P-Hoep/filter-design/bottle_filter_tank_hook.stl

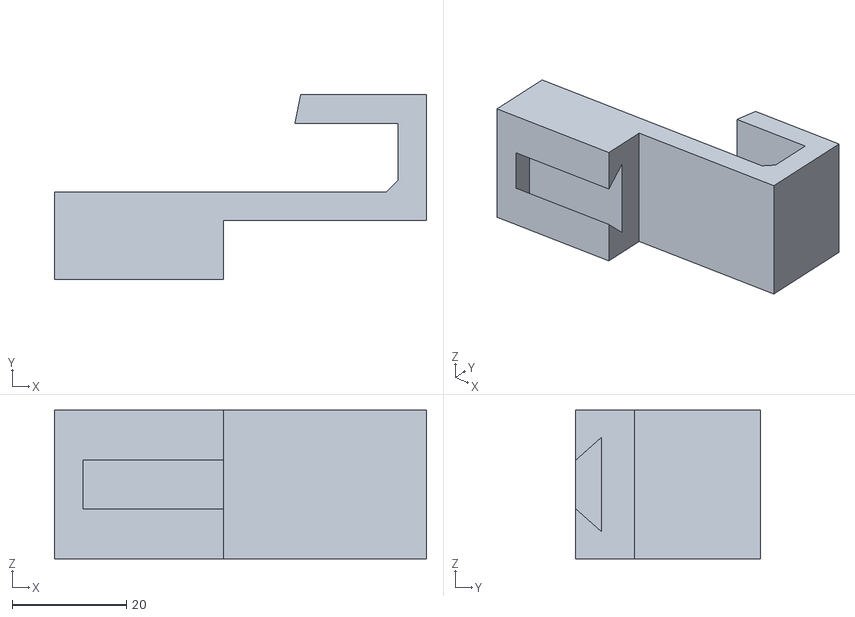
[picture p7: CAD file, 2026-10-12]
bottle_filter_tank_hook.stl
65.0 x 32.2 x 26.0
