P-Hoep/filter-design/mockup/installation_layout.dxf

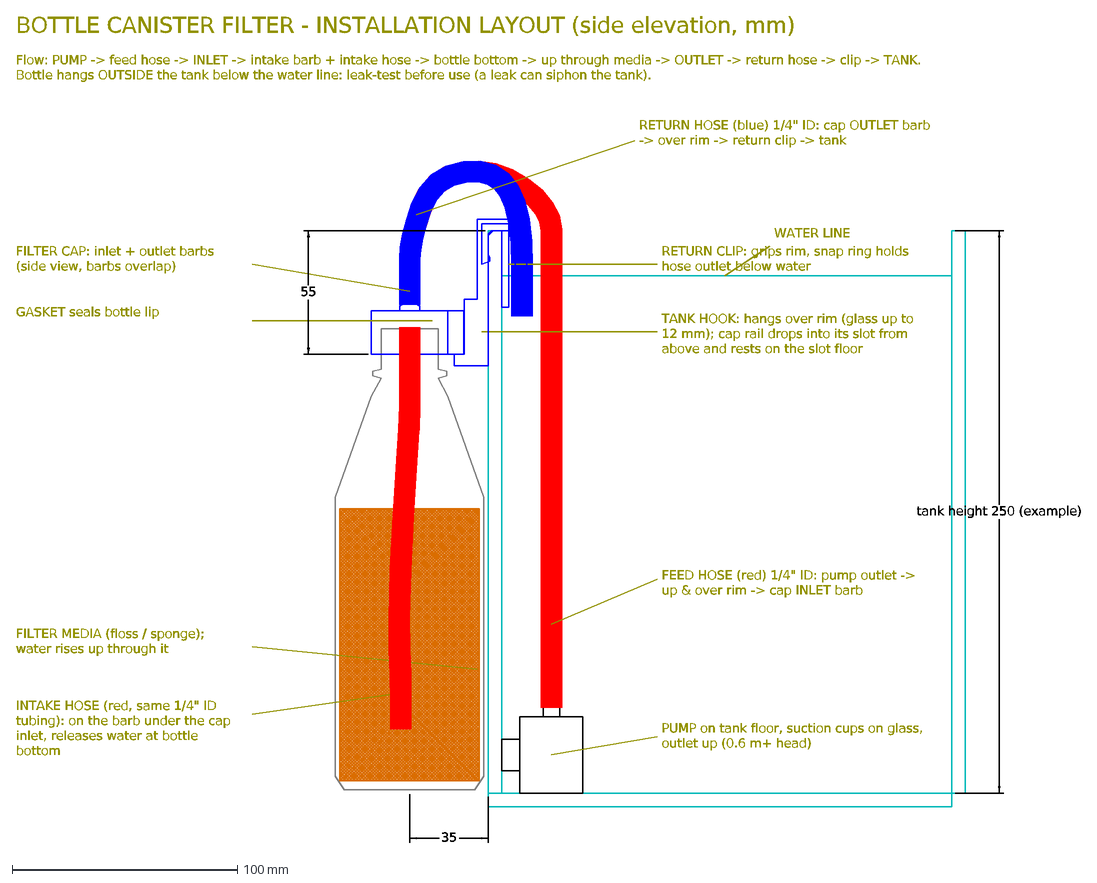
[picture p8: CAD file, 2026-10-12]
mockup/installation_layout.dxf
FEED HOSE (red) 1/4" ID: pump outlet -> up & over rim -> cap INLET barb
RETURN HOSE (blue) 1/4" ID: cap OUTLET barb -> over rim -> return clip -> tank
TANK HOOK: hangs over rim (glass up to 12 mm); cap rail drops into its slot from above and rests on the slot floor
PUMP on tank floor, suction cups on glass, outlet up (0.6 m+ head)
RETURN CLIP: grips rim, snap ring holds hose outlet below water
WATER LINE
FILTER MEDIA (floss / sponge); water rises up through it
INTAKE HOSE (red, same 1/4" ID tubing): on the barb under the cap inlet, releases water at bottle bottom
FILTER CAP: inlet + outlet barbs (side view, barbs overlap)
GASKET seals bottle lip
BOTTLE CANISTER FILTER - INSTALLATION LAYOUT (side elevation, mm)
Flow: PUMP -> feed hose -> INLET -> intake barb + intake hose -> bottle bottom -> up through media -> OUTLET -> return hose -> clip -> TANK. Bottle hangs OUTSID
55
tank height 250 (example)
35
