P-Hoep/filter-design/bottle_filter_cap.stl

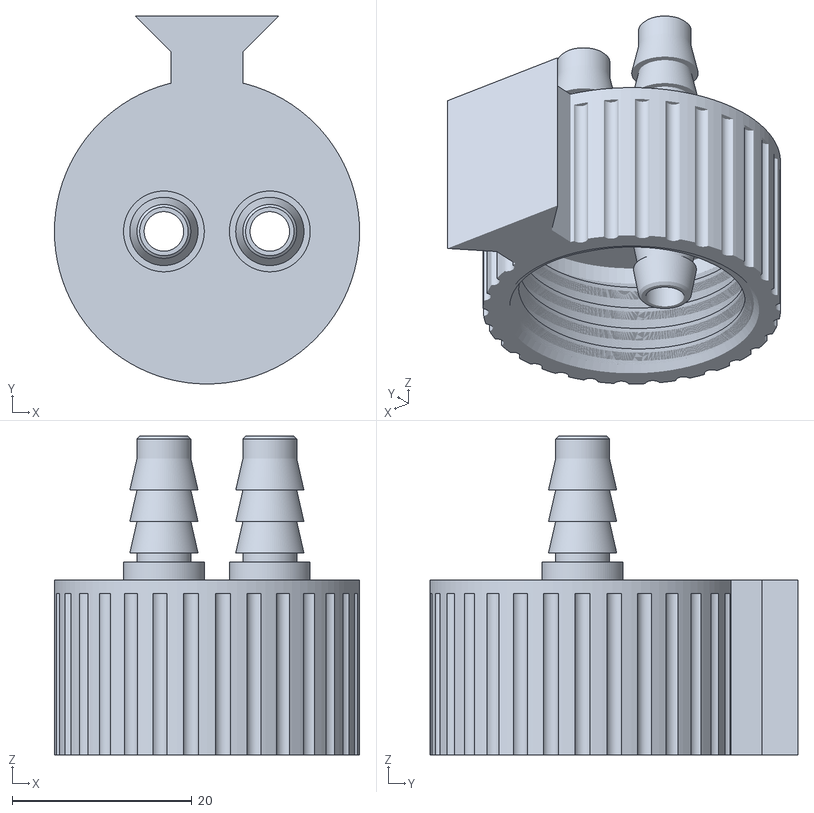
[picture p9: CAD file, 2026-10-12]
bottle_filter_cap.stl
34.0 x 41.0 x 35.5
