P-Hoep/filter-design/bottle_filter_gasket_tpu.stl

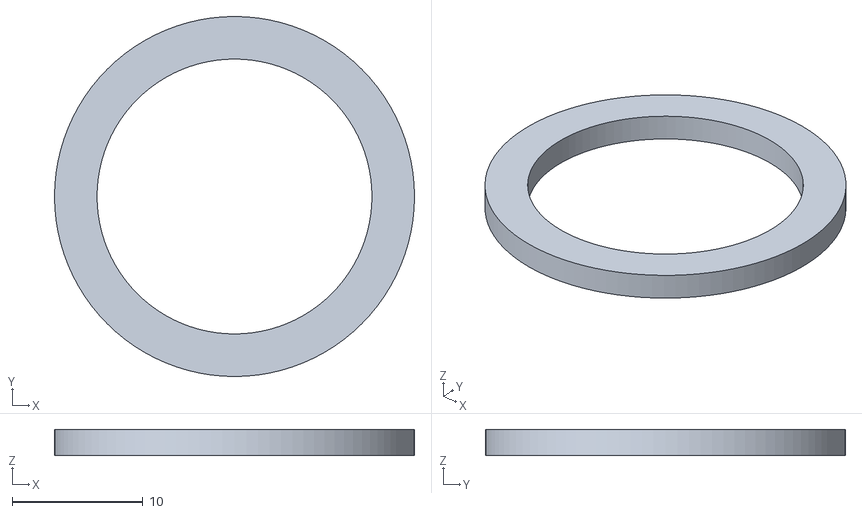
[picture p10: CAD file, 2026-10-12]
bottle_filter_gasket_tpu.stl
27.5 x 27.5 x 2.00
