P-Hoep/filter-design/bottle_filter_return_clip.stl

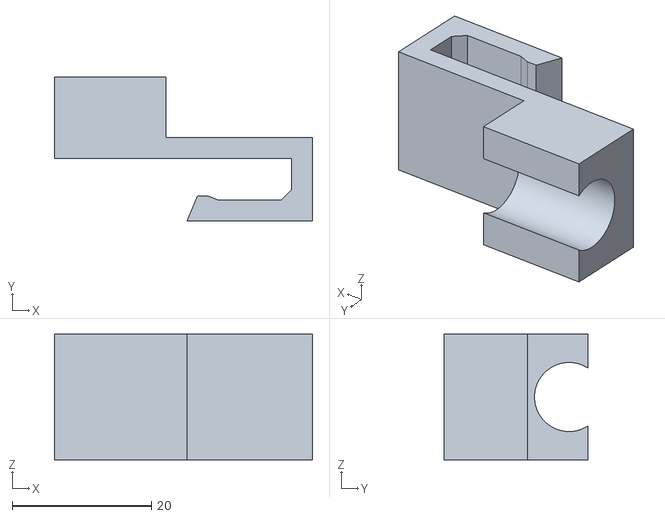
[picture p11: CAD file, 2026-10-12]
bottle_filter_return_clip.stl
37.0 x 20.7 x 18.0
