P-Hoep/filter-design/(list of files, cad)

Other CAD files:
bottle_filter_cap.dxf
mockup/filter_mockup_stills.blend
mockup/video/filter_flythrough.blend
