P-Hoep/filter-design/bottle_filter_assembly_preview.png

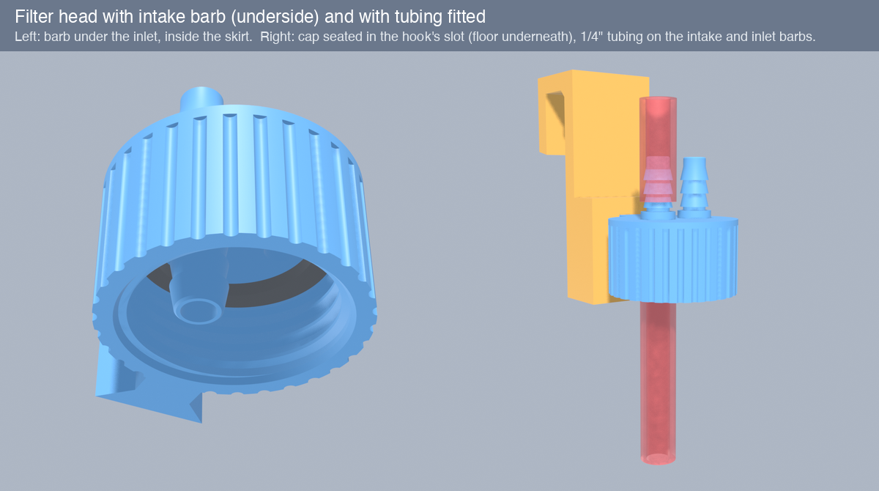
bottle_filter_assembly_preview.png
