P-Hoep/filter-design/(commit log)

2026-10-12 Replace printed dip tube with intake barb + flexible tubing
    The cap now has a downward barb under the inlet; a length of the same
    1/4" ID tubing pushes onto it and carries pump water to the bottle
    bottom. Ports moved to x -4.8 / +7.0 so the stretched hose fits inside
    the gasket ID and neck bore. The barb tip is flush with the open end so
    it prints standing on the bed.
    - Remove bottle_filter_dip_tube.stl and the inlet socket
    - Rebuild STLs, mockup GLB (red intake hose), stills, assembly preview
    - Update both CADCraft drawings (also fixes top-view port positions)
    - New narration line, re-rendered flythrough, 480p video and GIF
    - Save Blender scenes (flythrough + stills) into the repo
    - Update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
    [bottle_filter_cap.dxf, bottle_filter_cap.stl, bottle_filter_dip_tube.stl, filter_flythrough.blend, filter_mockup_stills.blend, installation_layout.dxf]
2026-10-12 Fix tank hook: slot open at top, floor carries the cap
    The dovetail slot was closed at the top and open at the bottom, so the
    bottle's weight would pull the cap's rail straight out of the hook. The
    slot is now open at the top with a 5 mm floor (SLOT_FLOOR) underneath:
    hang the hook, then drop the cap's rail in from above. Verified that
    the cap can't move down, lifts out upward, and can't pull off the glass.
    - Rebuild hook STL, mockup GLB, stills and assembly preview
    - Update hook side view and installation layout drawings
    - New narration line 6 with a lower camera that shows the floor;
    re-rendered flythrough, 480p video and GIF
    - Update README and design notes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
    [bottle_filter_cap.dxf, bottle_filter_tank_hook.stl, filter_flythrough.blend, filter_mockup_stills.blend, installation_layout.dxf]
